pindakaasbot/tt-rom-vga-screensaver/test/reference/frame0.png

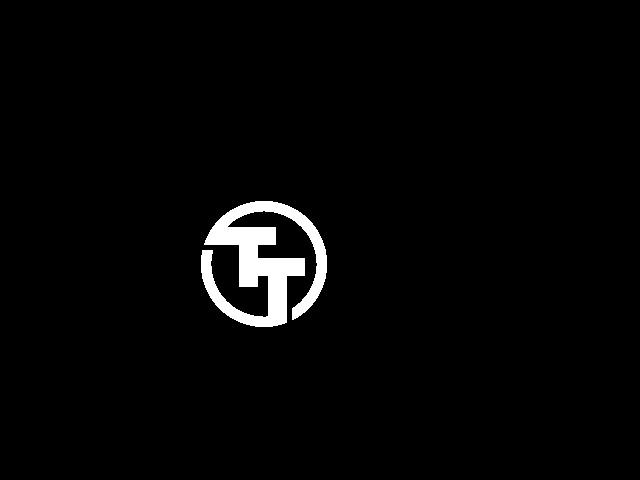
test/reference/frame0.png
