pindakaasbot/tt-rom-vga-screensaver/test/reference/frame2.png

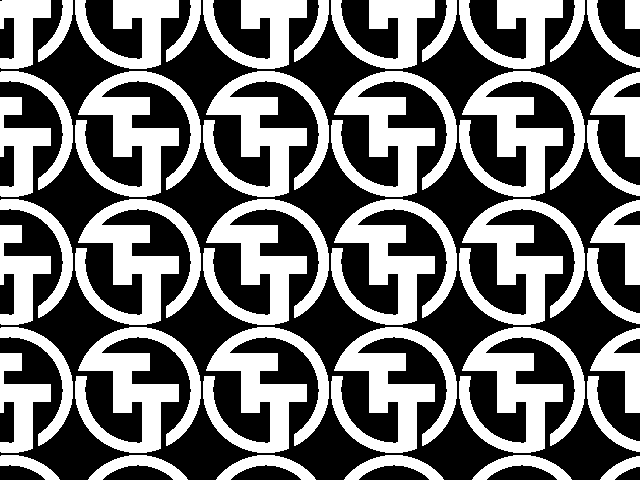
test/reference/frame2.png
