pindakaasbot/tt-rom-vga-screensaver/(commit log)

2026-03-06 feat: use librelane
    Switch from OpenLane 2 to its successor, LibreLane.
2026-03-06 chore: update CI/infra for ttsky26a shuttle
    - Switch workflows to tt-gds-action@ttsky26a with sky130A PDK
    - Update devcontainer to Ubuntu 24.04 and newer verible
    - Update docs and gitignore from template
2026-03-14 feat: 128x128 monochrome ROM with silicon art support
    Redesign ROM addressing for 128x128 1bpp bitmap instead of 64x64 6bpp.
    The new layout makes the transistor pattern in the GDS visually match
    the stored image, enabling silicon art visible in die photos.
    RTL: 8-to-1 mux pixel extraction, monochrome white-on-black output.
    Scripts: convert_1bpp.py (image→ROM), modify_rom.py (SPICE editor),
    modify_gds.py (GDS diffusion layer editor).
    Image: TT logo from TinyTapeout/tt-logo-screensaver.
    [rom_vga_logo.v, tt_um_rom_vga_screensaver.v]
2026-03-15 feat: update ROM macro with TT logo silicon art pattern
    Modified GDS diffusion layer and SPICE netlist to encode the
    TinyTapeout logo as a transistor pattern visible in die photos.
2026-03-15 feat: regenerate ROM macro with rom_gen (no density fill for silicon art)
    Use the proper ROM generator script instead of manual GDS editing.
    Density fill disabled so the TT logo transistor pattern is clearly
    visible in die photos.
2026-03-15 fix: correct ROM orientation for GDS and restore .lib port names
    - Swap X/Y in ROM address mapping so image X maps to wordlines (GDS X)
    and image Y maps to bitlines (GDS Y), fixing 90-degree rotation
    - Flip Y with ~y in RTL to keep GDS right-side up
    - Restore original .lib (generator uses 'data' bus, we need 'q')
    [tt_um_rom_vga_screensaver.v]
2026-03-15 fix: rotate ROM data 180 degrees for correct GDS orientation
    [tt_um_rom_vga_screensaver.v]
2026-03-15 chore: remove double-size mode (no longer needed at 128x128)
    [test.py, tt_um_rom_vga_screensaver.v]
